kutilz/robotic-arm/tools/cetak/grid-2mm-a4.pdf

0 | 20 | 40 | 60 | 80 | 100 | 120 | 140 | 160 | 180

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
### cek skala X: harus 100.0 mm

cek skala Y: harus 100.0 mm
