kutilz/robotic-arm/benchmarks/data/accuracy_sample.csv

joint | mode | commanded_deg | measured_deg | run
J2 | open | 45.0 | 43.1 | 1
J2 | open | 45.0 | 42.7 | 2
J2 | open | 45.0 | 43.6 | 3
J2 | closed | 45.0 | 44.8 | 1
J2 | closed | 45.0 | 45.1 | 2
J2 | closed | 45.0 | 44.9 | 3
J3 | open | 30.0 | 28.4 | 1
J3 | open | 30.0 | 29.1 | 2
J3 | open | 30.0 | 28.0 | 3
J3 | closed | 30.0 | 29.8 | 1
J3 | closed | 30.0 | 30.1 | 2
J3 | closed | 30.0 | 29.9 | 3
J4 | open | 90.0 | 88.5 | 1
J4 | open | 90.0 | 87.9 | 2
J4 | open | 90.0 | 89.0 | 3
J4 | closed | 90.0 | 89.7 | 1
J4 | closed | 90.0 | 90.2 | 2
J4 | closed | 90.0 | 89.6 | 3
