kutilz/robotic-arm/benchmarks/data/accuracy_summary.csv

joint | mode | n_posisi | n_per_posisi | AP_mean_deg | AP_max_deg | RP_deg | SD_deg | err_maks_deg
J1 | closed | 5 | 30 | 0.0839 | 0.1057 | 0.1494 | 0.0498 | 0.1800
J1 | open | 5 | 30 | 0.1611 | 0.1800 | 0.1927 | 0.0642 | 0.3000
J2 | closed | 5 | 30 | 0.1188 | 0.1367 | 0.1870 | 0.0623 | 0.2500
J2 | open | 5 | 30 | 0.6830 | 0.7993 | 0.6205 | 0.2068 | 1.6600
J3 | closed | 5 | 30 | 0.0972 | 0.1070 | 0.1738 | 0.0579 | 0.2300
J3 | open | 5 | 30 | 0.4448 | 0.5107 | 0.3362 | 0.1121 | 1.1700
J4 | closed | 5 | 30 | 0.0684 | 0.0810 | 0.1401 | 0.0467 | 0.2100
J4 | open | 5 | 30 | 0.1181 | 0.1247 | 0.2298 | 0.0766 | 0.2900
