kutilz/robotic-arm/schematics/components/17HS2401.jpg

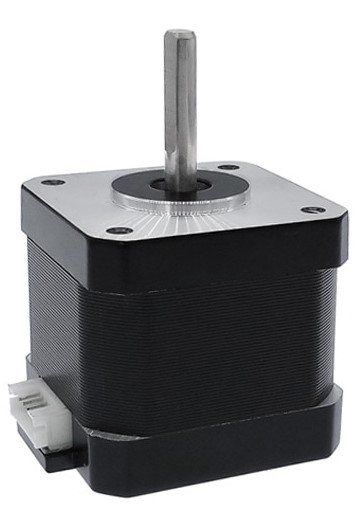
schematics/components/17HS2401.jpg
