kutilz/robotic-arm/schematics/components/17HS6401S.png

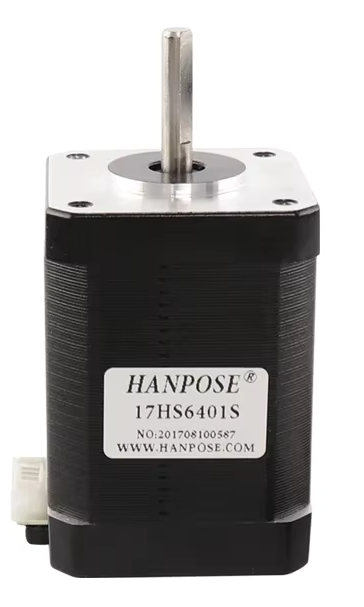
schematics/components/17HS6401S.png
