kutilz/robotic-arm/schematics/components/ESP32-38p.jpeg

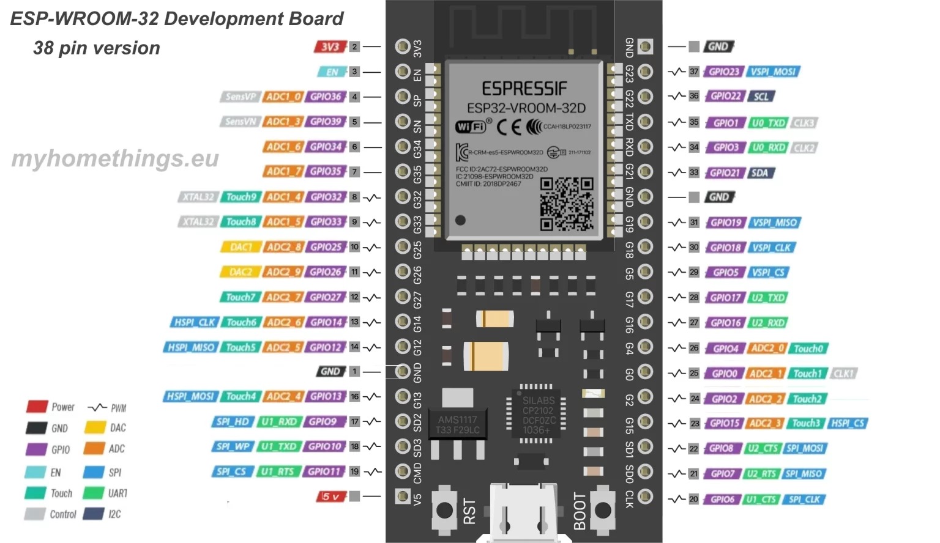
schematics/components/ESP32-38p.jpeg
