kutilz/robotic-arm/schematics/components/images.jpeg

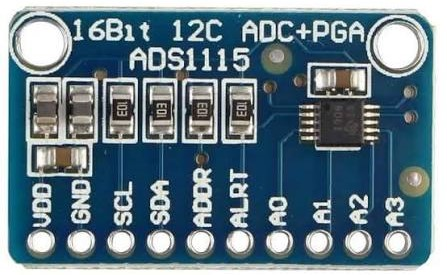
schematics/components/images.jpeg
