kutilz/robotic-arm/schematics/components/tca9548a.jpg

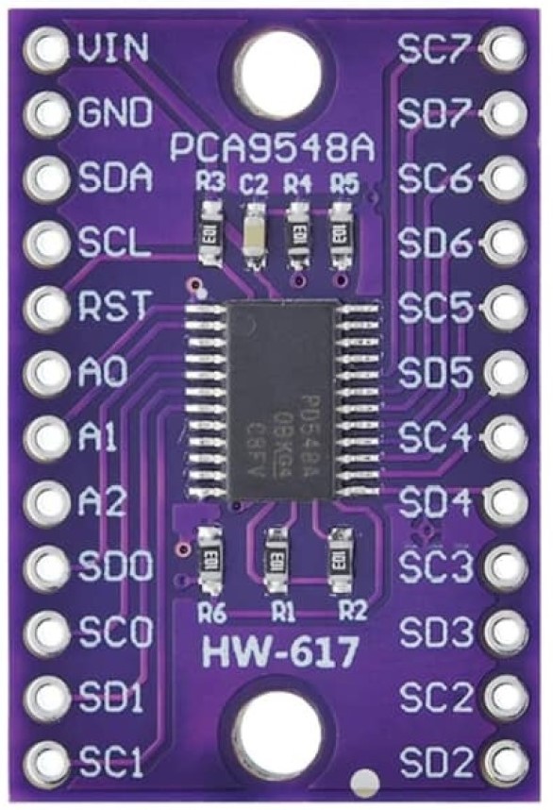
schematics/components/tca9548a.jpg
