kutilz/robotic-arm/schematics/components/TMC2209.jpg

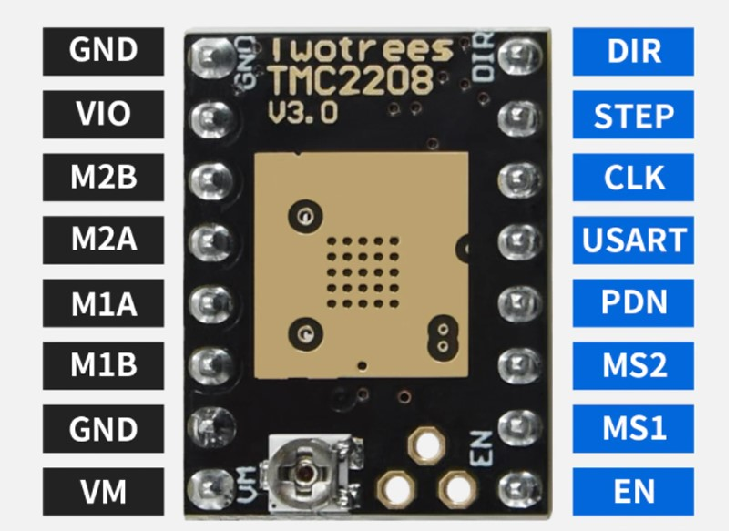
schematics/components/TMC2209.jpg
