kutilz/robotic-arm/tools/cetak/tes-garis-printer.pdf

Tes garis printer, petak 1 mm. Cetak 1:1, lalu lihat dari jarak baca.

Pilih lebar paling tipis yang garisnya masih rata, sama hitam, dan tidak menyatu.

garis vertikal (arah scan) | garis horizontal (arah feed kertas)

0.05 mm

0.07 mm

0.09 mm

0.10 mm

0.12 mm

0.15 mm

0.20 mm

0.25 mm

0.30 mm

0.40 mm

Catatan: pada 600 dpi 1 dot = 0.042 mm, jadi lebar di bawah 0.09 mm biasanya dibulatkan ke 1 sampai 2 dot dan ketebalannya jadi tidak seragam antar garis.
