kutilz/robotic-arm/benchmarks/data/control_disturbance.csv

test | joint | mode | t_ms | angle_deg | note
droop-0.2kg-tcp | J2 | open | 0 | 29.957
droop-0.2kg-tcp | J2 | open | 20 | 29.985
droop-0.2kg-tcp | J2 | open | 40 | 29.967
droop-0.2kg-tcp | J2 | open | 60 | 30.009
droop-0.2kg-tcp | J2 | open | 80 | 30.007
droop-0.2kg-tcp | J2 | open | 100 | 30.012
droop-0.2kg-tcp | J2 | open | 120 | 30.002
droop-0.2kg-tcp | J2 | open | 140 | 30.029
droop-0.2kg-tcp | J2 | open | 160 | 30.011
droop-0.2kg-tcp | J2 | open | 180 | 30.037
droop-0.2kg-tcp | J2 | open | 200 | 30.052
droop-0.2kg-tcp | J2 | open | 220 | 30.038
droop-0.2kg-tcp | J2 | open | 240 | 29.994
droop-0.2kg-tcp | J2 | open | 260 | 29.969
droop-0.2kg-tcp | J2 | open | 280 | 30.025
droop-0.2kg-tcp | J2 | open | 300 | 30.001
droop-0.2kg-tcp | J2 | open | 320 | 29.964
droop-0.2kg-tcp | J2 | open | 340 | 30.000
droop-0.2kg-tcp | J2 | open | 360 | 29.965
droop-0.2kg-tcp | J2 | open | 380 | 29.981
droop-0.2kg-tcp | J2 | open | 400 | 30.037
droop-0.2kg-tcp | J2 | open | 420 | 29.970
droop-0.2kg-tcp | J2 | open | 440 | 30.032
droop-0.2kg-tcp | J2 | open | 460 | 29.991
droop-0.2kg-tcp | J2 | open | 480 | 30.004
droop-0.2kg-tcp | J2 | open | 500 | 29.998
droop-0.2kg-tcp | J2 | open | 520 | 29.969
droop-0.2kg-tcp | J2 | open | 540 | 29.998
droop-0.2kg-tcp | J2 | open | 560 | 29.987
droop-0.2kg-tcp | J2 | open | 580 | 30.018
droop-0.2kg-tcp | J2 | open | 600 | 30.000
droop-0.2kg-tcp | J2 | open | 620 | 30.032
droop-0.2kg-tcp | J2 | open | 640 | 29.948
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
kehilangan-langkah | J3 | closed | 2700 | -30.099
kehilangan-langkah | J3 | closed | 2720 | -30.203
kehilangan-langkah | J3 | closed | 2740 | -30.044
kehilangan-langkah | J3 | closed | 2760 | -30.118
kehilangan-langkah | J3 | closed | 2780 | -30.154
