kutilz/robotic-arm/benchmarks/data/control_loop.csv

state | sample | period_ms
idle | 1 | 4.28
idle | 2 | 4.18
idle | 3 | 3.78
idle | 4 | 4.00
idle | 5 | 3.46
idle | 6 | 4.94
idle | 7 | 3.58
idle | 8 | 3.03
idle | 9 | 3.74
idle | 10 | 4.40
idle | 11 | 4.54
idle | 12 | 4.24
idle | 13 | 3.03
idle | 14 | 3.16
idle | 15 | 3.80
idle | 16 | 3.58
idle | 17 | 5.34
idle | 18 | 4.55
idle | 19 | 3.43
idle | 20 | 2.76
idle | 21 | 3.38
idle | 22 | 4.29
idle | 23 | 5.06
idle | 24 | 3.12
idle | 25 | 3.35
idle | 26 | 4.11
idle | 27 | 2.77
idle | 28 | 4.70
idle | 29 | 3.65
idle | 30 | 3.66
idle | 31 | 3.70
idle | 32 | 3.80
idle | 33 | 2.86
idle | 34 | 4.45
idle | 35 | 4.64
idle | 36 | 3.61
idle | 37 | 3.46
idle | 38 | 2.61
idle | 39 | 4.18
idle | 40 | 3.21
idle | 41 | 3.83
idle | 42 | 4.63
idle | 43 | 2.90
idle | 44 | 4.07
idle | 45 | 3.77
idle | 46 | 3.30
idle | 47 | 3.23
idle | 48 | 2.95
idle | 49 | 3.64
idle | 50 | 5.03
idle | 51 | 4.16
idle | 52 | 3.99
idle | 53 | 3.47
idle | 54 | 3.42
idle | 55 | 2.69
idle | 56 | 4.63
idle | 57 | 3.40
idle | 58 | 2.82
idle | 59 | 4.18
idle | 60 | 3.54
idle | 61 | 4.14
idle | 62 | 4.26
idle | 63 | 3.09
idle | 64 | 3.37
idle | 65 | 2.99
idle | 66 | 3.24
idle | 67 | 4.13
idle | 68 | 4.21
idle | 69 | 3.22
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
