kutilz/robotic-arm/benchmarks/data/control_loop_summary.csv

state | n | mean_ms | p95_ms | maks_ms
idle | 3000 | 3.800 | 5.040 | 27.130
moving | 3000 | 4.348 | 6.130 | 28.490
