kutilz/robotic-arm/tools/cetak/grid-mm-a4.pdf

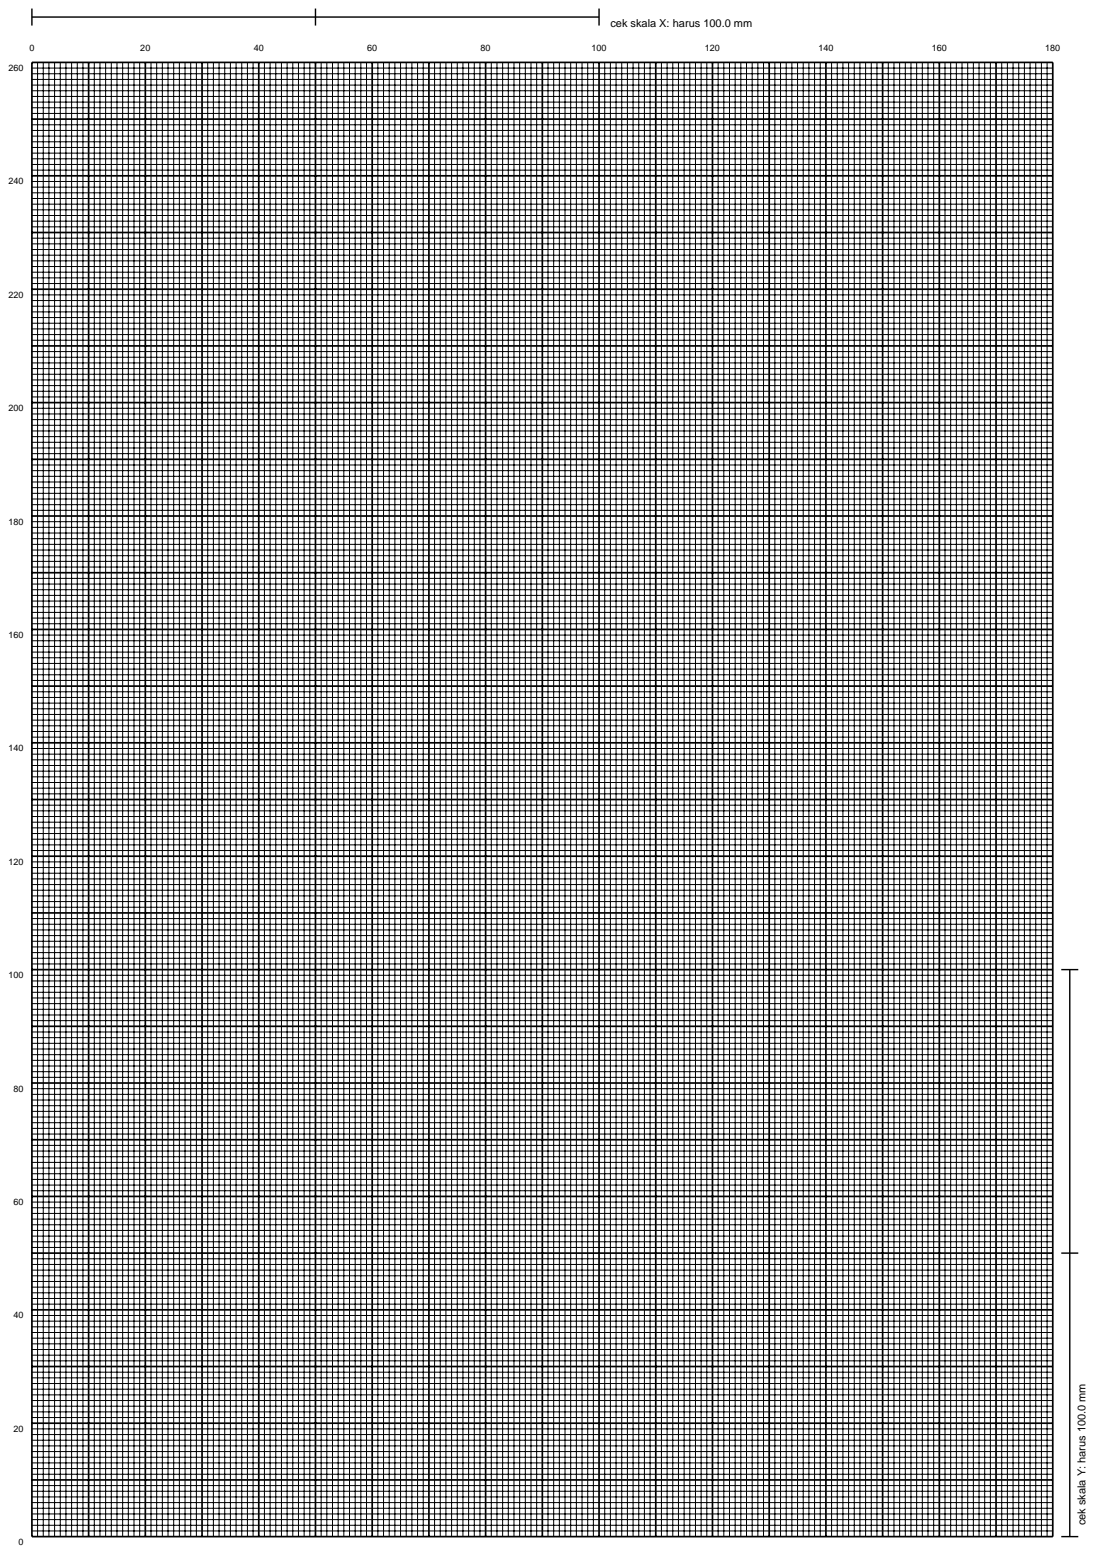
[picture p13: page 1]

cek skala X: harus 100.0 mm

cek skala Y: harus 100.0 mm
