kutilz/robotic-arm/(commit log)

2026-06-28 Init: lengan robot 6-DOF cycloidal + position feedback + digital twin
    Struktur awal skripsi "Rancang Bangun Robotic Arm 6-DOF 3D Printed dengan
    Mekanisme Position Feedback dan Interface Digital Twin Berbasis Web":
    - src/arm: config, sizing torsi/gearbox, forward kinematics (DH), bridge digital twin
    - firmware: closed-loop stepper + encoder AS5600 (Arduino)
    - benchmarks: uji torsi & efisiensi (prediksi vs terukur)
    - studio: digital twin web (Three.js)
    - thesis: outline penulisan skripsi
    - docs/research: dokumen sizing motor & cycloidal
    - tests: verifikasi perhitungan = dokumen riset (8 lulus)
    [efficiency_sample.csv, torque_sample.csv]
2026-06-28 Encoder feedback hibrida + benchmark akurasi & latensi
    Ganti asumsi "6x AS5600" jadi arsitektur hibrida sesuai budget:
    - 4x AS5600 (absolut, di output sendi) untuk J1/J2/J3/J5 -> ikut ukur backlash
    - 2x encoder optik incremental (disk 24 lubang + 2x TLP1025 quadrature,
    96 cpr, di poros motor) untuk J4/J6 -> resolusi output 0.25°
    - config.py: tipe encoder per sendi + perhitungan resolusi efektif + peta
    - firmware: dukung dua jenis encoder (AS5600 I2C + optik quadrature), homing
    - 3 test baru untuk pemetaan & resolusi encoder
    Benchmark hasil utama skripsi (pilar 2 & 3):
    - accuracy_test.py: akurasi, repeatability (ISO 9283), open-loop vs closed-loop
    - latency_test.py: latensi end-to-end, up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
    [accuracy_sample.csv, latency_sample.csv]
2026-07-05 Studio: remake UI jadi floating panels ala Waldo Commander (dark-only)
    - Scene 3D full-viewport; kontrol jadi panel floating glass: status card
    TCP kanan-atas, control card ber-tab JOINT/CARTESIAN/MOTION/SETUP
    dengan E-STOP bulat, timeline pill, scene panel view, icon strip kamera
    - Panel teknik (torque/sizing/offsets/geometri) pindah ke Engineering
    drawer tersembunyi; pose slider digabung ke baris jog per-sendi
    - Tema light dihapus; icons.js SVG inline baru; keyboard shortcut demo
    (Space/H/1-4/I-F-S-T/E/G/Esc); logika kinematics/IK/bridge tak berubah
    - Termasuk migrasi modular Vite dari legacy/index.html (belum pernah
    ter-commit) + catat dampak draf di thesis/perubahan-log.md
    Co-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
    [arm.js, bridge.js]
2026-07-30 gitignore: output simulasi, node_modules, kredensial WiFi, model CAD besar
    - benchmarks/data/{workspace_sim,torque_map,ik_verify,error_model}.csv
    di-ignore: regenerable dari skrip, bukan data pengukuran
    - firmware/arm_controller_esp32/wifi_secrets.h di-ignore (repo public),
    template tetap di wifi_secrets.h.example
    - node_modules/, studio/dist/, studio/node_modules/, *.log, .gstack/
    - Model CAD besar regenerable via export Onshape: *.glb, *.gltf, *.step, *.stp
2026-07-30 Desain 3D final: 6 FeatureScript generator Onshape + skematik komponen
    Desain mekanik sudah beku. Sumber kebenaran geometri = FeatureScript
    parametrik di onshape/, bukan file STEP/GLB (export besar, di-gitignore):
    - Cycloidal Generator.fs (v5) - all-in-one, 7 defineFeature v4 diringkas
    jadi 1 feature dengan parameter shared + auto layout (semua bore/pin
    circle diturunkan dari Dr/N/pin/bearing/e) + validasi yang menolak
    konfigurasi tak muat dengan angka konkret
    - Drive Train Generator.fs - rangkaian transmisi per sendi
    - HTD3M Pulley.fs - pulley belt J1 (12T/20T/60T) dan J3 (20T->60T)
    - Ball Groove Generator.fs - alur thrust bearing cetak 3D
    - Gripper.fs, Nut Hole Generator.fs
    schemat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
2026-07-30 Docs riset: arsitektur final terkunci (payload 0.2 kg, reach 0.6 m)
    arsitektur_final_robotic_arm_6dof.md - dokumen sizing yang menggantikan
    angka laporan riset awal. Yang berubah:
    - Payload 0.5 -> 0.2 kg, reach 0.70 -> 0.60 m
    - Wrist J5/J6 pindah dari stepper+cycloidal (~0.45 kg) ke 2x MG996R
    (~55 g each): massa ujung kolaps, torsi J2/J3 turun drastis
    - J2 jadi DIRECT cycloidal single motor coaxial di pivot (moment arm ~0),
    belt dicabut. Belt dipakai di J3 yang motornya direlokasi proksimal
    - Motor J4 ikut direlokasi keluar dari ujung
    Riset pendukung:
    - J4J5J6 Motor Decisions.md - verifikasi 17PM-K054 ternyata hybrid 1.8
    derajat (bukan PM kasar), go/no-go MG996R di J5 yang jalan 60-70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
2026-07-30 Parameter fisik & DH di-rebase ke geometri terukur CAD (19 test lulus)
    config.py jadi satu-satunya sumber konstanta fisik; benchmark mengimpor
    dari sini, tidak hardcode ulang.
    Geometri DH sekarang diukur langsung dari assembly CAD, bukan proporsi
    antropomorfik ideal. Dua offset yang dulu tidak dimodelkan sekarang masuk:
    - a1 offset lateral bahu 65.9 mm (twin meleset ~66 mm)
    - a3 offset perpendicular siku 50.0 mm (twin meleset ~50 mm)
    a2 upper arm 288.1 mm terukur; d4 forearm 220 mm dan d6 wrist->TCP 90 mm
    masih usulan yang mudah diubah. Reach dari sumbu J2 = 0.604 m (target 0.60).
    Pergelangan bola J4/J5/J6 tetap concurrent, syarat Pieper terpenuhi.
    Aktuator & transmisi final masuk config: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
2026-07-30 Benchmark: 6 simulasi baru + pengolah data kendali, semua pakai geometri baru
    Modul bersama:
    - armlib.py - sampling joint dalam limit, FK batch numpy, Jacobian numerik,
    indeks manipulability, model torsi gravitasi J2/J3, util plot & CSV
    - vizstyle.py - gaya grafik seragam, tetap terbaca untuk color vision
    deficiency dan cetak hitam-putih
    - datacheck.py - pengaman supaya data *_sample.csv (contoh FORMAT kolom)
    tidak pernah kepakai sebagai hasil yang dilaporkan
    Simulasi (semua mengimpor konstanta dari src/arm/config.py):
    1. workspace_sim.py - peta workspace Monte Carlo, envelope XZ/XY, volume
    voxel, dead zone silinder akibat offset lateral bahu a1
    2. torque_map.py - sapuan torsi grav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
    [accuracy_summary.csv, current_derating.csv, efficiency_sample.csv, efficiency_summary.csv, latency_summary.csv, payload_map.csv, torque_sample.csv, torque_summary.csv]
2026-07-30 Firmware ESP32: WebSocket host sendiri, closed-loop P, kalibrasi persisten
    arm_controller_esp32/ jadi sketch aktif. ESP32 host WebSocket server sendiri
    (ws://<ip>:81), jadi web nyambung LANGSUNG; Python bridge tidak lagi wajib
    untuk hardware nyata (tetap dipakai mode --simulate). Sketch Mega
    (arm_controller/) turun status jadi legacy.
    Prinsip: firmware = EXECUTOR primitif + guardrail. Sequencing kalibrasi, uji
    rasio, konversi gram->torsi, dan logging hidup di studio. Yang tinggal di
    firmware cuma yang wajib real-time lokal: ramp step, koreksi closed-loop,
    e-stop, validasi & clamp input.
    Kendali: P murni (kp default 0.4), BUKAN PID. Koreksi hanya dieksekusi saat
    stepper idle supaya feedback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
2026-07-30 Studio: tab CAL komisioning, view cube, overlay CAD, geometri baru
    Tab CAL (calPanel.js) - panel komisioning gaya PLC/servo-drive. Konsisten
    dengan prinsip firmware = executor primitif: semua sequencing, perhitungan
    (uji rasio, gram->Newton->torsi, peak hold), dan logging CSV data skripsi
    hidup di sini, bukan di firmware.
    - Interlock MONITOR | SERVICE ala key-switch: semua aksi TULIS (jog, zero,
    dir, apply, commit, tare) terkunci selama MONITOR
    - SERVICE aktif -> poll diag ~5 Hz: pilot lamp magnet AS5600 (MD/ML/MH+AGC)
    per axis, raw angle, StallGuard, load cell, info WiFi
    - Semantik drive industrial: APPLY = cal_set (RAM) vs COMMIT = cal_save (NVS)
    vs DEFAULTS = cal_reset
    viewCube.js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
    [arm.js, bridge.js, calPanel.js]
2026-07-30 README: sinkron dengan arsitektur final dan sketch ESP32
    Aktuator, transmisi, jalur feedback, dan diagram arsitektur diperbarui
    mengikuti dokumen arsitektur final. ESP32 melayani WebSocket sendiri,
    bridge Python jadi opsional (mode --simulate / board Mega legacy).
2026-07-30 Konteks kerja: arsip riset chat + config Claude Code
    chat-archive/ - transkrip sesi riset (pemilihan motor, cycloidal, TMC2209,
    AS5600, material cetak) yang jadi jejak keputusan desain. Disimpan supaya
    alasan di balik angka bisa ditelusuri saat menulis skripsi.
    .claude/launch.json - dev server studio (npm run dev, port 5173).
    .claude/settings.local.json - allowlist perintah lokal.
2026-07-30 Geometri di-rebase ke CAD final: siku tanpa offset, forearm 270 mm
    - Ukur ulang sumbu tiap sendi dari lingkaran bearing/pin di STEP assembly
    final (bukan dari bounding box): a1 65.85, a2 288.00, a3 0.00, d3 -11.80,
    d4 270.00, d6 90.55 mm. Simpangan fit <= 0.001 mm untuk J1-J5.
    - a3 (offset perpendicular siku, dulu 50 mm) HILANG: sumbu J3 dan J4 sekarang
    benar-benar berpotongan. Geseran lateralnya pindah jadi d3 sepanjang sumbu J3.
    - Rasio transmisi diverifikasi dari CAD, semuanya cocok dengan config.py: pin
    cycloidal J2=30 @R38, J3=10 @R30, J4=15 @R35; pulley 12T/60T + 20T/60T (J1)
    dan 20T/60T (belt J3). Status TENTATIVE pada J4 dicabut.
    - Kriteria Pieper diperiksa ulang dari CAD: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
    [current_derating.csv, payload_map.csv]
2026-07-31 Alat ukur CAD: kenali sendi dari fitur, bukan dari koordinat hafalan
    Versi pertama measure_cad_geometry.py memakai koordinat sumbu hasil ukuran
    sebelumnya sebagai tebakan awal. Begitu assembly di-export pada pose berbeda,
    J3-J6 ikut berpindah dan skripnya langsung buta ("TIDAK KETEMU") walau
    geometrinya sama persis. Sekarang identifikasinya murni dari hubungan
    geometri yang melekat di part:
    - J2/J3/J4 dikenali dari cincin pin roller cycloidal (lubang Ø4-7 mm tersusun
    melingkar). Jumlah pin & radius pin-circle tidak berubah oleh pose.
    - J2 = gearbox terdekat ke PANGKAL J1. Sempat salah memakai jarak garis-ke-garis
    ke sumbu J1: sumbu J4 kebetulan hampir memotong perpanjangan sumbu J1 (~1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
2026-07-31 Feedback J5/J6 pindah ke ADS1115 (dokumen dulu, kode belum dimigrasi)
    Membatalkan keputusan 2026-07-27 yang menetapkan ADC1 internal ESP32.
    Wiper potensiometer MG996R sekarang masuk ADS1115 (ADC eksternal 16-bit,
    alamat 0x48) yang menumpang bus I2C yang sama dengan mux TCA9548A.
    Gripper MG90S ikut jalur itu di kanal A2, tetapi tidak masuk JOINTS
    karena bukan derajat kebebasan.
    JUJUR SOAL STATUS: yang berubah baru dokumentasinya (config.py, header
    .ino, pinout.md, firmware/README.md). Kode firmware MASIH memakai
    analogReadMilliVolts() di GPIO 34/35 dan belum dimigrasi ke ADS1115.
    Ini ditulis eksplisit di komentar SERVO_FEEDBACK supaya tidak terbaca
    seolah sudah jalan.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
2026-07-31 Hapus em dash di seluruh repo (aturan penulisan)
    Em dash dilarang di seluruh repo, termasuk kode, docs, dan arsip. Diganti
    koma, titik dua, atau tanda kurung sesuai fungsinya di kalimat. 53 berkas:
    README, CONTRIBUTING, docs riset, benchmark, studio, FeatureScript onshape,
    dan arsip chat.
    thesis/ sengaja tidak ikut: naskah dikerjakan terpisah dan belum di-push.
2026-07-31 Massa dan torsi di-rebase ke hasil ukur slicer + STEP, plus FEA disk J2
    Mengganti model massa hasil ESTIMASI dokumen riset dengan angka terukur, tanpa
    timbangan: volume dan luas permukaan tiap part dihitung dari mesh 3mf, dimodelkan
    sebagai shell padat + rongga infill, lalu dikalibrasi ke total filament slicer
    (1054.36 g). Posisi part diambil dari centroid awan titik di STEP.
    Temuan:
    - Density efektif terentang 0.50-1.26 g/cm3 antar part, jadi satu konstanta
    density untuk semua part TIDAK sah. Rencana awal menimbang satu part lalu
    memakai rasionya untuk semua akan meleset sampai 88% di part tertentu.
    - 45% massa cetak (476 g dari 1054 g) ada di base dan tidak dibawa J2. Part
    terberat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
2026-08-03 Gambar skripsi dari render CAD 3D, plus rombakan Arm Studio ke rantai CAD
    Empat gambar baru di thesis/figures/ yang merender rakitan Onshape yang
    sebenarnya lewat WebGL, menggantikan screenshot Onshape yang cuma 146 sampai
    207 dpi di kolom teks 14 cm:
    lengan-dimensi garis ukur a1/a2/d4/d6, sumbu J1-J6, pergelangan
    spherical, plus audit pertentangan Tabel 3.1
    lengan-pose-kerja 4 pose, kamera dan kotak bingkai dan skala sama persis
    lengan-mekanisme 9 penunjuk ke tiap subrakitan penggerak, 2 varian
    cycloidal-j2-exploded exploded J2, urut aliran daya kiri ke kanan
    Render WebGL ditempel sebagai data: URI ke dalam SVG Fig.build(), anotasi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
2026-08-03 Catatan bring-up bench: AMS1117 cacat, erratum ADC1 vs HX711, daya pancar WiFi
    Temuan sesi bench 2026-07-31, disimpan supaya gejalanya tidak didiagnosis
    ulang dari nol.
    - AMS1117 bawaan board bench di luar spesifikasi (3.1-3.2 V) sehingga brownout
    tiap WiFi.mode(). Sudah diganti; 3V3 terukur 3.289 V. Daftar hal yang TIDAK
    menolong ikut dicatat supaya tidak diulang.
    - SERVO_FEEDBACK dimatikan selama fase bench motor telanjang: ADC1 di
    GPIO34/35 sebank dengan GPIO36 = HX711 DT, dan erratum ESP32 memunculkan
    pulsa LOW palsu yang terbaca sebagai data-ready bohongan.
    - setTxPower() dipanggil setelah WiFi.mode() (sebelum itu ditolak), dan
    ditegaskan bukan obat brownout.
    - Encoder FAULT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
    [arm_controller_esp32.ino]
2026-08-03 Geometri di-rebase ke CAD final, gambar CAD masuk Bab III, plus 4 bug perkakas
    Rantai DH sekarang berhenti di muka flange (d6 = 0,09055 m) dan gripper jadi
    tool terpisah lewat TOOL_TCP_FROM_FLANGE. Alasannya gripper bisa diganti:
    kalau d6 menelannya, tiap penggantian menuntut ubah tabel DH, firmware, dan
    digital twin sekaligus. Titik massa payload tetap pindah ke TCP ujung jaw,
    karena itu keputusan statika dan bebas dari endpoint d6.
    config.py di-rebase ke Main Assembly (Complete): d1 0,06484 -> 0,0728,
    d3 -0,0118 -> -0,012463, d4 0,270 -> 0,269762. Diverifikasi dua jalur ukur
    terpisah (lingkaran STEP di Python, mesh GLB di JS) yang sepakat dalam 0,25 mm.
    Seluruh benchmark dijalankan ulang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
    [current_derating.csv, payload_map.csv]
2026-08-12 Konfigurasi deploy Vercel untuk studio + banner CAD versi produksi
    vercel.json di root supaya repo bisa di-import ke Vercel tanpa mengubah
    setting apa pun: install/build dijalankan dengan --prefix studio dan output
    diarahkan ke studio/dist.
    Banner "mesh CAD tidak ada" di build produksi tidak lagi menampilkan perintah
    node tools/optimize_cad_glb.mjs (instruksi mesin lokal, tidak relevan buat
    penonton web); pesan dev tetap seperti semula.
    Claude-Session: https://claude.ai/code/session_01QLBmqKi6r8kgdsjoNExXCx
2026-08-12 Dokumentasi deploy web Vercel di studio/README
    Catat kenapa vercel.json perlu (root repo terdeteksi Python karena
    pyproject.toml), alternatif Root Directory = studio, dan konsekuensi
    main-assembly.glb yang gitignored terhadap tampilan situs hasil deploy.
    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
2026-08-12 Banner "mesh CAD tidak ada" tidak muncul di build produksi
    Situs deploy dipakai untuk presentasi, jadi peringatan GLB absen hanya
    mengganggu penonton. Di build dev banner tetap tampil lengkap dengan perintah
    optimize_cad_glb.mjs supaya alasan tampilan skeleton tetap jelas saat kerja
    lokal. Banner "memuat mesh CAD" tetap ada di kedua build karena berguna begitu
    GLB-nya benar-benar disertakan.
    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
2026-08-12 Model blok sederhana sebagai pengganti mesh CAD saat GLB tidak ada
    main-assembly.glb gitignored 1,8 MB, jadi situs hasil deploy selama ini cuma
    menampilkan skeleton garis. Sekarang studio memasang model blok: satu balok
    atau silinder per part, ditempel ke partHost yang sama dengan mesh CAD supaya
    rantai sendi, exploded view, x-ray, dan toggle tampilan tidak perlu tahu
    bedanya.
    Ini bukan mesh CAD dan tidak meniru detailnya. Yang dijaga akurat hanya posisi
    (pusat bbox tiap part dari CAD_PARTS, hasil ukur GLB rev 2026-08-03) dan ukuran
    (bbox part dari docs/bom-main-assembly.md). Hasilnya bbox rakitan 226,0 x 250,7
    x 815,6 mm vs 240 x 266 x 815,7 mm yang terukur di CAD. Satu-satunya baris yang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
2026-09-20 Keluarkan materi skripsi, arsip literatur, dan transkrip chat dari repo
    Repo ini akan dibuka ke publik, jadi tiga kelompok berkas dikeluarkan dari
    pelacakan git. Semuanya tetap ada di disk lokal, hanya tidak ikut terbit.
    - Materi skripsi (thesis/, sidang/, paper-ieee/, panduan penulisan UPI, dan
    perkakas yang hanya melayani naskah). Naskahnya belum disidangkan dan belum
    terbit, jadi tidak dipublikasikan lebih dulu.
    - Arsip literatur pihak ketiga: mirror HTML artikel dan ekstrak teks penuh
    paper. Hak ciptanya milik penulis aslinya. .gitignore sudah mengecualikan
    PDF-nya dengan alasan yang sama sejak awal, tapi HTML dan teksnya lolos.
    Yang tetap di-track INDEX.md, sumber-url.txt, da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
2026-09-20 Bring-up hardware: kalibrasi sendi dan servo, web UI ESP32, studio mobile
    Kumpulan kerja bangku yang belum sempat masuk repo, dari pengukuran sampai
    perkakas yang memungkinkan pengukurannya.
    Kalibrasi dan data
    - tools/kalibrasi_sendi.py, kalibrasi_servo.py, kalibrasi_analisa.py:
    pengambilan dan pembedahan data kalibrasi. Analisa memecah kurva galat jadi
    offset, skala, dan harmonik 1 sampai 3 supaya ketahuan mana yang berpola dan
    mana yang sisa acak.
    - benchmarks/kalibrasi/: data mentah J1 dan servo J5/J6/gripper, plus README
    yang menjelaskan tiap kolom dan dua jebakan yang bisa bikin salah baca,
    yaitu ground bounce dan pemetaan dua titik.
    - benchmarks/data/control_*.csv: loop tert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
    [accuracy_summary.csv, cek_awal.csv, control_disturbance.csv, control_disturbance_summary.csv, control_loop.csv, control_loop_summary.csv, control_noise.csv, control_noise_summary.csv]
2026-09-20 README: halaman depan yang berdiri di atas hasil ukur, bukan klaim
    README lama menjual rencana: tabel sizing hasil hitungan dan roadmap yang
    sebagian besar masih kotak kosong. Sekarang alatnya sudah jadi dan sudah
    diukur, jadi yang ditampilkan hasil ukurnya.
    - Angka utama diambil dari benchmarks/, bukan dari perhitungan desain. Galat
    posisi loop tertutup lawan terbuka per sendi, latensi digital twin, waktu
    loop kendali, torsi terukur, dan efisiensi cycloidal.
    - Batasan ikut ditulis apa adanya: ketelitian absolut J1 dibatasi pemasangan
    magnet encoder dan bukan kendali, J5 tidak pernah benar-benar diam, dan
    efisiensi cycloidal 63 sampai 66 persen meleset dari asumsi desain 75.
    - docs/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
2026-09-20 Demo web menampilkan mesh CAD asli, dan README menautkannya
    Situs live sebelumnya jatuh ke model blok karena *.glb di-gitignore tanpa
    kecuali, jadi pengunjung tidak pernah melihat CAD yang sebenarnya. Mesh hasil
    tools/optimize_cad_glb.mjs sudah dikecilkan dari 31,7 MB ke 1,8 MB, dan repo
    sesudah pembersihan history cuma 2,6 MB, jadi ongkosnya sekarang murah.
    - .gitignore: satu pengecualian untuk studio/public/main-assembly.glb. Aturan
    *.glb yang umum tetap berlaku buat export mentah Onshape.
    - README: tombol demo di bawah badge, tautan di keterangan gambar, dan satu
    jalan pintas di bagian quick start buat yang tidak mau memasang apa pun.
    Demo: https://robotic-arm-psi.vercel.app
    Co-Aut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
2026-09-20 Foto demonstrasi diganti satu frame video: lengan dan twin dalam satu gambar
    Foto lama cuma menunjukkan lengan terpasang di meja, dan klaim utama proyek ini
    justru tidak kelihatan di situ. Frame t=18 detik dari rekaman 13 Agustus 2026
    menunjukkan keduanya sekaligus: lengan menahan pose mendatar penuh, dan di layar
    di belakangnya twin memperagakan sudut sendi yang sama. Itu yang sebenarnya
    dijual repo ini, dan sekarang terbaca tanpa perlu membaca satu baris pun.
    - docs/img/demo-live.jpg menggantikan arm-built.jpg, jadi hero selebar halaman
    karena isinya dua hal sekaligus, bukan lagi dua gambar bersebelahan.
    - Tangkapan layar Arm Studio turun ke bagian "The digital twin" sendiri, tempat
    d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
2026-10-06 Kendali lewat internet: jalur CLOUD lewat relay, lease, dan tingkat link
    Jalur lokal (ws://:81) tetap; jalur CLOUD ditambahkan sebagai pilihan.
    ESP32 menyambung KELUAR ke relay Cloudflare (relay/), jadi twin di https
    bisa mengendalikan lengan dari mana saja tanpa PC, WiFi rumah, atau install.
    Firmware:
    - cloud_link.h: klien wss di task core 0, antrean ke loop(), e-stop berbendera
    - blok JALUR: satu pemegang kendali (lokal selalu menang), lease per perintah
    gerak (lengan direm saat perintah berhenti datang), whitelist perintah cloud
    - J5/J6 dibatasi laju speed yang sama dengan stepper
    - TLS diverifikasi ke root CA Cloudflare (cloud_ca.h, tools/gen_cloud_ca.py)
    Relay: Worker + Durable Obje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
2026-10-06 Relay di-deploy; pintu pages.dev karena XL memblokir *.workers.dev
    Uji pertama relay yang sudah online: XL Axiata membelokkan DNS semua
    subdomain *.workers.dev (termasuk kueri ke 1.1.1.1) ke halaman blokir.
    Relay ditambah pintu Cloudflare Pages (armbot-relay.pages.dev) yang
    memakai gerbang yang sama (src/gate.js) dan Durable Object pinjaman dari
    Worker, jadi state lengan tetap satu. Studio dan contoh firmware memakai
    host pages.dev.
    Diuji lewat internet sungguhan: uji ujung ke ujung (simulator sebagai
    lengan) lulus semua, twin publik di Vercel tersambung lewat CLOUD.
